CalvEngIO/IsoBunny/IsoBunny-BOM.xlsx

IsoBunny Rev B |  |  |  |  |  |  |  |  |  |  | Total | $13.66 |  | $0.42
BOM # | Comment | Designator | Description | Mounting Type | Package | Manufacturer | Manufacturer Part Number | Supplier | Supplier Part Number | Price per unit | Quantity | Price Total | 100 units | Price Total
1 | MCP6002 | OP1,OP4 | General Purpose Amplifier 2 Circuit Rail-to-Rail 8-SOIC | SMD | 8-SOIC | Microchip Technology | MCP6002T-I/SN | Digi-Key | MCP6002T-I/SNCT-ND | $0.34 | 2 | $0.68 |  | $0.00
2 | LM2904 | OP2,OP3 | General Purpose Amplifier 2 Circuit 8-SO | SMD | 8-SOIC | Diodes Incorporated | LM2904QS-13 | Digi-Key | LM2904QS-13DICT-ND | $0.38 | 2 | $0.76 | $0.21 | $0.42
3 | AP2210N-5.0 | LDO1 | Linear Voltage Regulator IC 1 Output 300mA SOT-23-5 | SMD | SOT-23-5 | Diodes Incorporated | AP2210N-5.0TRG1 | Digi-Key | AP2210N-5.0TRG1DICT-ND | $0.43 | 1 | $0.43 |  | $0.00
4 | HCNR200-300E | IC1,IC2 | Optoisolator Photovoltaic, Linearized Output 5000Vrms 1 Channel 8-DIP Gull Wing | SMD | 8-SMD, Gull Wing | Broadcom Limited | HCNR200-300E | Digi-Key | 516-1608-5-ND | $4.09 | 2 | $8.18 |  | $0.00
5 | Header Pins | J1,J2,J3,J4,J5,J6 | Connector Header Through Hole 40 position 0.100" (2.54mm)' | THT |  | Sullins Connector Solutions | PREC040SAAN-RC | Digi-Key | S1012EC-40-ND | $0.51 | 1 | $0.51 |  | $0.00
6 | 2.2uF capacitor | C1, C2,C3,C4,C5,C6,C7,C8,C9,C10 | 16V, X5R | SMD | 0603 | Murata Electronics North America | GRM188R61C225KE15D | Digi-Key | 490-3296-1-ND | $0.13 | 10 | $1.30 |  | $0.00
7 | 806 Ohm resistor | R5,R6,R7,R8,R9,R12,R13,R18 | 806 Ohms ±1% 0.1W, 1/10W Chip Resistor 0603 (1608 Metric) Automotive AEC-Q200 Thick Film | SMD | 0603 | Stackpole Electronics Inc. | RMCF0603FT806R | Digi-Key | RMCF0603FT806RCT-ND | $0.10 | 6 | $0.60 |  | $0.00
8 | 154k resistor | R1,R3,R14,R16 | 154 kOhms ±1% 0.1W, 1/10W Chip Resistor 0603 (1608 Metric) Automotive AEC-Q200 Thick Film | SMD | 0603 | Stackpole Electronics Inc. | RMCF0603FT154K | Digi-Key | RMCF0603FT154KCT-ND | $0.10 | 4 | $0.40 |  | $0.00
9 | 200k resistor | R10,R11 | 200 kOhms ±1% 0.1W, 1/10W Chip Resistor 0603 (1608 Metric) Moisture Resistant Thick Film | SMD | 0603 | Stackpole Electronics Inc. | CR0603-FX-2003ELF | Digi-Key | CR0603-FX-2003ELFCT-ND | $0.10 | 2 | $0.20 |  | $0.00
10 | 287k resistor | R2,R4,R15,R17 | 287 kOhms ±1% 0.1W, 1/10W Chip Resistor 0603 (1608 Metric) Automotive AEC-Q200 Thick Film | SMD | 0603 | Stackpole Electronics Inc. | RMCF0603FT287K | Digi-Key | RMCF0603FT287KCT-ND | $0.10 | 4 | $0.40 |  | $0.00
11 | 402k resistor | R2,R4,R15,R17 | 402 kOhms ±1% 0.1W, 1/10W Chip Resistor 0603 (1608 Metric) Automotive AEC-Q200 Thick Film | SMD | 0603 | Stackpole Electronics Inc. | RMCF0603FT402K | Digi-Key | RMCF0603FT402KCT-ND | $0.10 | 2 | $0.20 |  | $0.00
