CalvEngIO/IsoBunny/IsoBunny.brd

## EAGLE design IsoBunny.brd (2019-06-02)

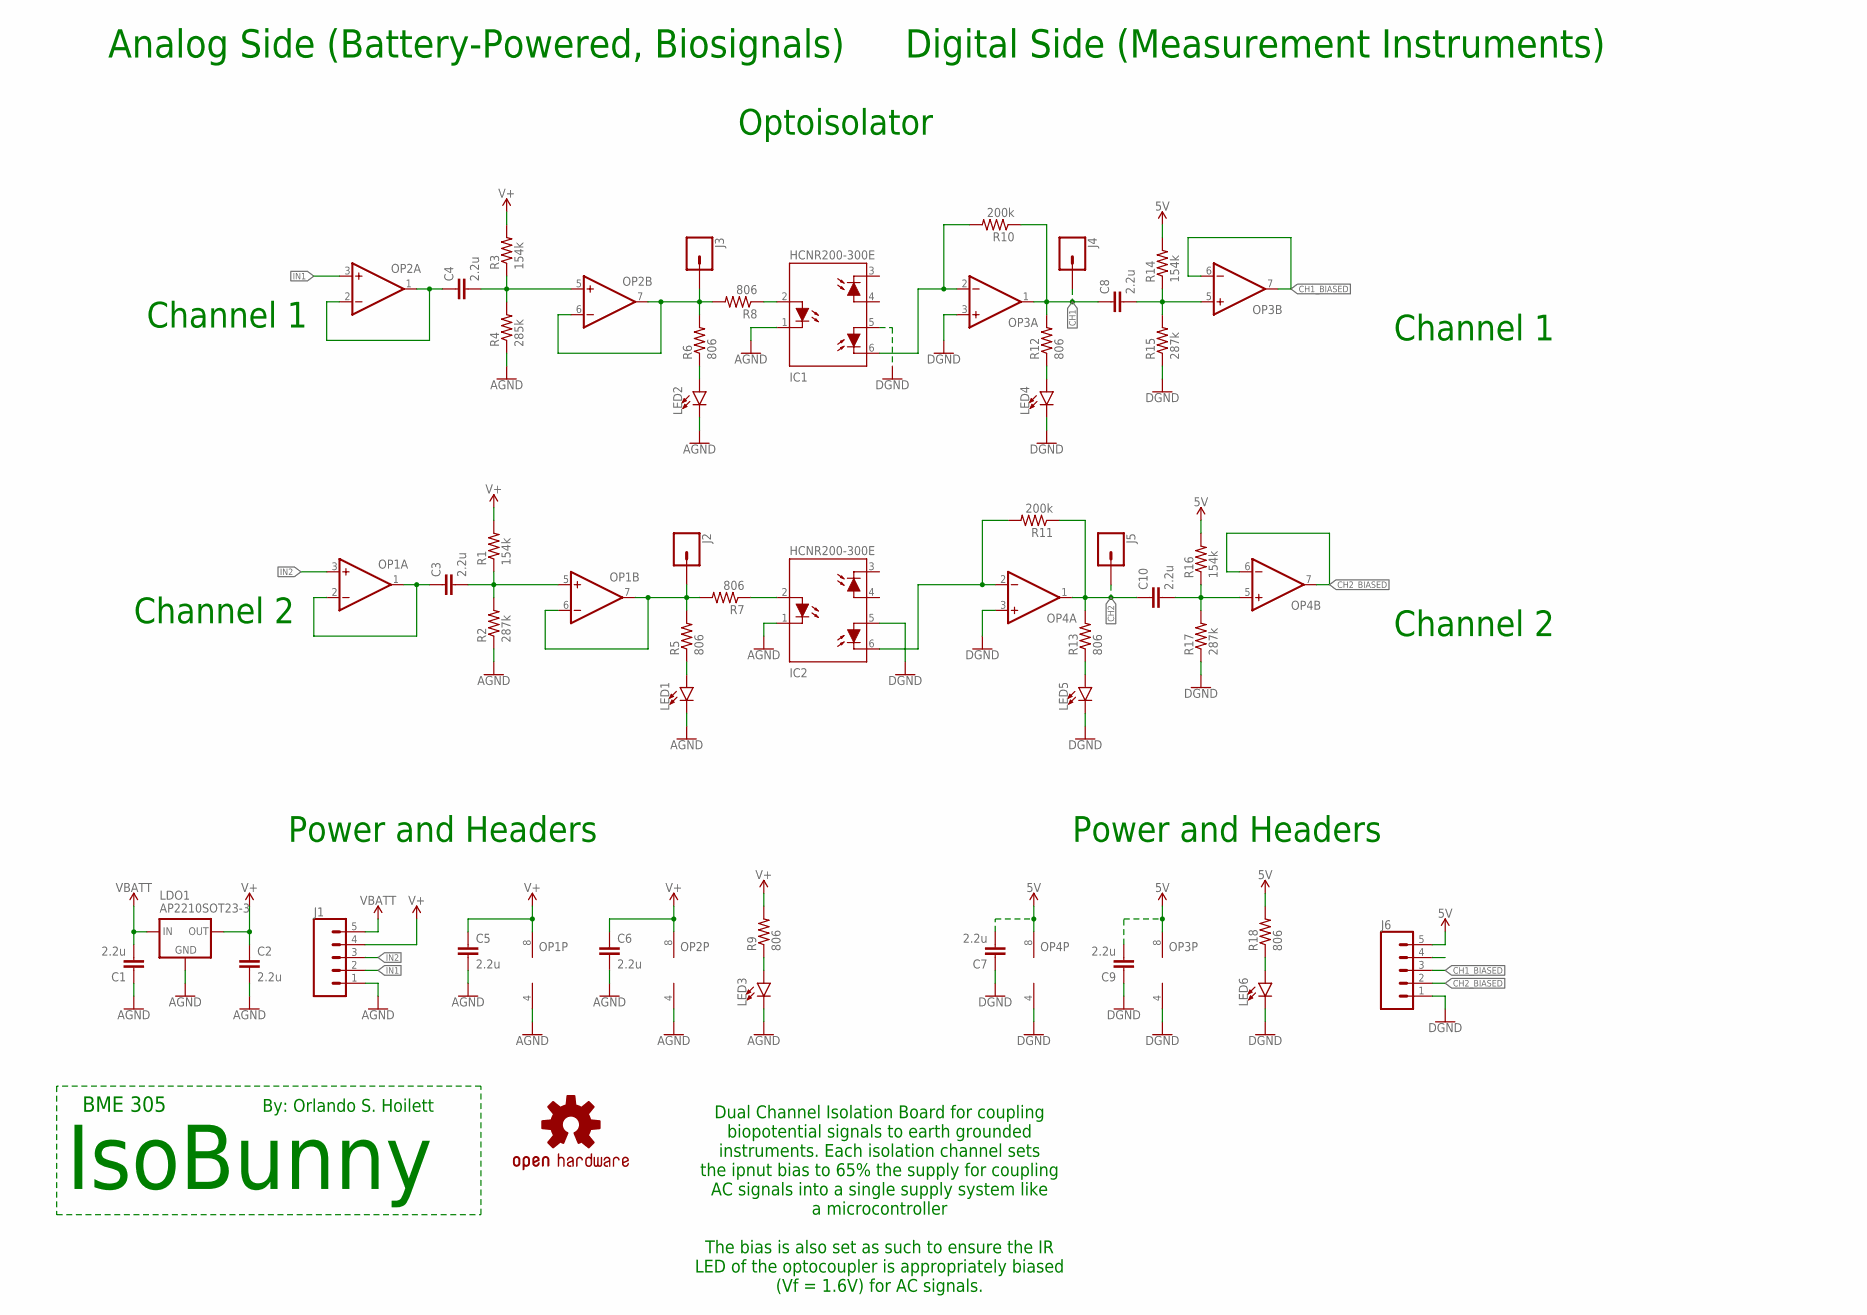
[picture p1: schematic IsoBunny.sch]

Parts:
C1, C2, C3, C4, C5, C6, C7, C8, C9, C10: 2.2u; C0603
IC1, IC2: HCNR200-300E; DIP8-400
J1, J6: CONN_05; 1X05
J2, J3, J4, J5: CONN_01PTH_NO_SILK_KIT; 1X01NS_KIT
LDO1: AP2210SOT23-3; SOT23
LED1, LED2, LED3, LED4, LED5, LED6: LED5MM; LED_5MM
LOGO1: OSHW-LOGOL; OSHW-LOGO-L
OP1, OP2, OP3, OP4: OP-DUALR; SO8
R1, R3, R14, R16: 154k; R0603
R2, R15, R17: 287k; R0603
R4: 285k; R0603
R5, R6, R7, R8, R9, R12, R13, R18: 806; R0603
R10, R11: 200k; R0603
REV1: REVISION.A; REV.A
U$1: PURDUE_BME_HANDLE; PURDUE_BME_HANDLE.1

Connections:
5V: C7.2, C9.2, J6.5, OP3.8 (V+), OP4.8 (V+), R14.2, R16.2, R18.2
AGND: C1.1, C2.2, C5.2, C6.2, IC1.1 (C), IC2.1 (C), J1.1, LDO1.1 (GND), LED1.K (C), LED2.K (C), LED3.K (C), OP1.4 (V-), OP2.4 (V-), R2.1, R4.1
CH1: C8.1, J4.1, OP3.1 (OUT), R10.1, R12.2
CH1_BIASED: J6.3, OP3.6 (-IN), OP3.7 (OUT)
CH2: C10.1, J5.1, OP4.1 (OUT), R11.1, R13.2
CH2_BIASED: J6.2, OP4.6 (-IN), OP4.7 (OUT)
DGND: C7.1, C9.1, IC1.5 (A2), IC2.5 (A2), J6.1, LED4.K (C), LED5.K (C), LED6.K (C), OP3.3 (+IN), OP3.4 (V-), OP4.3 (+IN), OP4.4 (V-), R15.1, R17.1
IN1: J1.2, OP2.3 (+IN)
IN2: J1.3, OP1.3 (+IN)
unnamed: C4.1, OP2.1 (OUT), OP2.2 (-IN)
unnamed: LED3.A, R9.1
unnamed: C4.2, OP2.5 (+IN), R3.1, R4.2
unnamed: C3.1, OP1.1 (OUT), OP1.2 (-IN)
unnamed: IC1.6 (C2), OP3.2 (-IN), R10.2
unnamed: C3.2, OP1.5 (+IN), R1.1, R2.2
unnamed: IC2.6 (C2), OP4.2 (-IN), R11.2
unnamed: LED6.A, R18.1
unnamed: IC2.2 (A), R7.1
unnamed: C10.2, OP4.5 (+IN), R16.1, R17.2
unnamed: LED2.A, R6.1
unnamed: IC1.2 (A), R8.1
unnamed: C8.2, OP3.5 (+IN), R14.1, R15.2
unnamed: LED4.A, R12.1
unnamed: LED1.A, R5.1
unnamed: LED5.A, R13.1
OUT1: J3.1, OP2.6 (-IN), OP2.7 (OUT), R6.2, R8.2
OUT2: J2.1, OP1.6 (-IN), OP1.7 (OUT), R5.2, R7.2
V+: C2.1, C5.1, C6.1, J1.4, LDO1.2 (OUT), OP1.8 (V+), OP2.8 (V+), R1.2, R3.2, R9.2
V_BATT: C1.2, J1.5, LDO1.3 (IN)

Notes on the sheet:
Analog Side (Battery-Powered, Biosignals)
Digital Side (Measurement Instruments)
Channel 1
Channel 2
Power and Headers
Optoisolator
Dual Channel Isolation Board for coupling biopotential signals to earth grounded instruments. Each isolation channel sets the ipnut bias to 65% the supply for coupling AC signals into a single supply system like a microcontroller The bias is also set as such to ensure the IR LED of the optocoupler 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
IsoBunny
BME 305
By: Orlando S. Hoilett

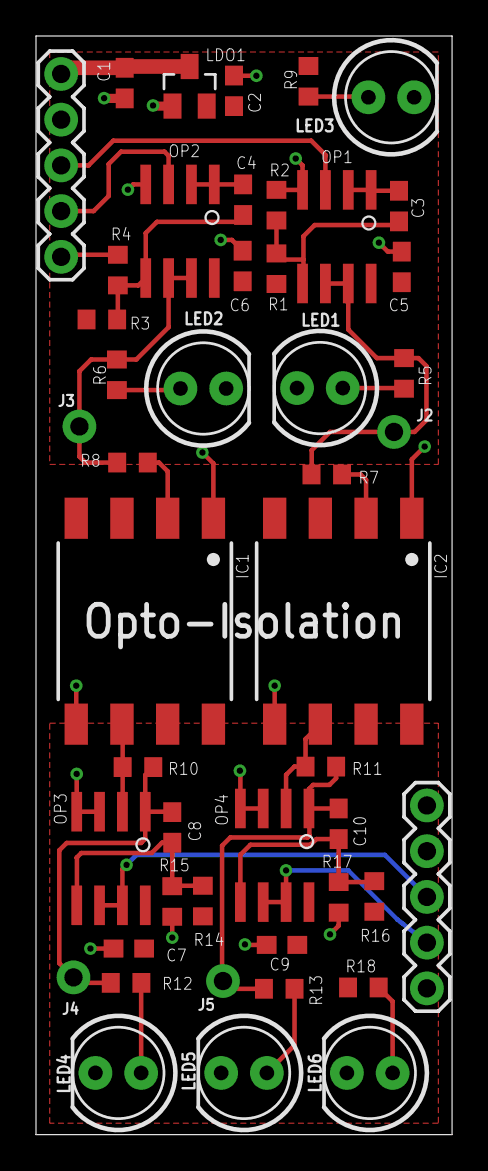
[picture p2: board IsoBunny.brd from above]

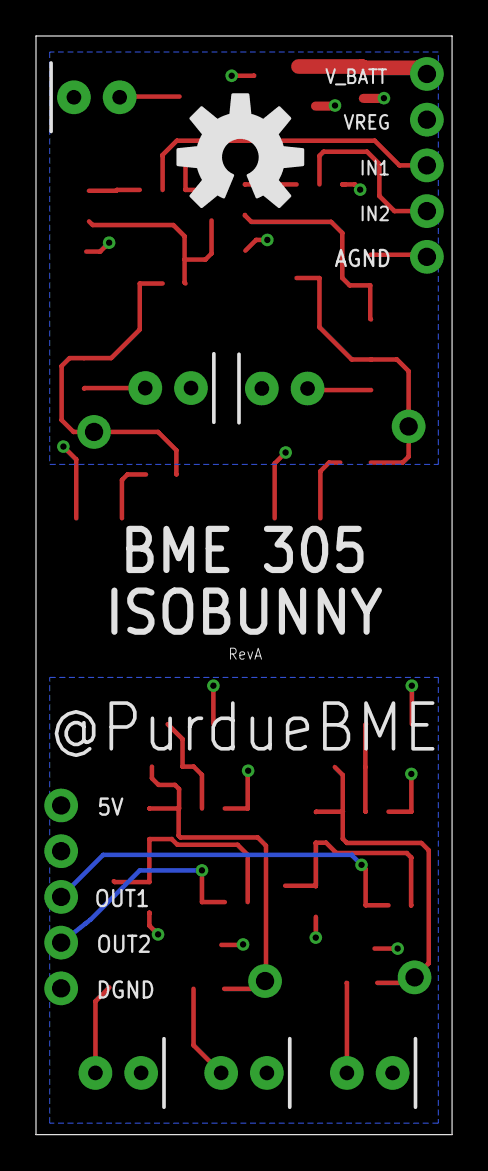
[picture p3: board IsoBunny.brd from below]

Board: 2 copper layers, 23.1 x 61.0 mm, 50 parts (3 on the bottom side), 29 nets.
