CalvEngIO/IsoBunny/(commit log)

2019-06-02 committ with working designs
    [IsoBunny-BOM.xlsx, IsoBunny.brd, IsoBunny.sch]
2019-06-02 renamed Gerber zip file
